HALtheWise/eclectronics-project2/README.md

# eclectronics-project2

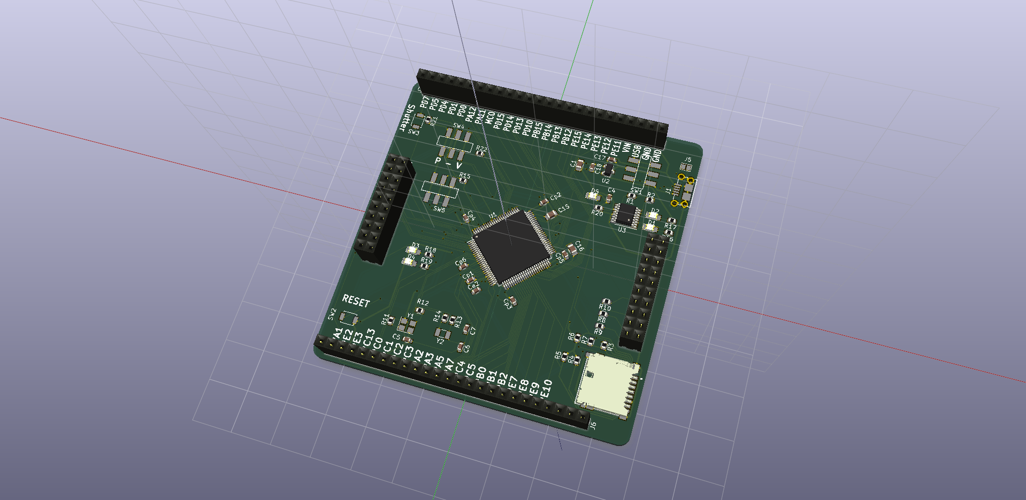
[picture p1: camboard/camboard.png]
camboard
