HALtheWise/eclectronics-project2/camboard/camboard.kicad_pcb

## KiCad design camboard/camboard.kicad_pcb (2017-10-13)

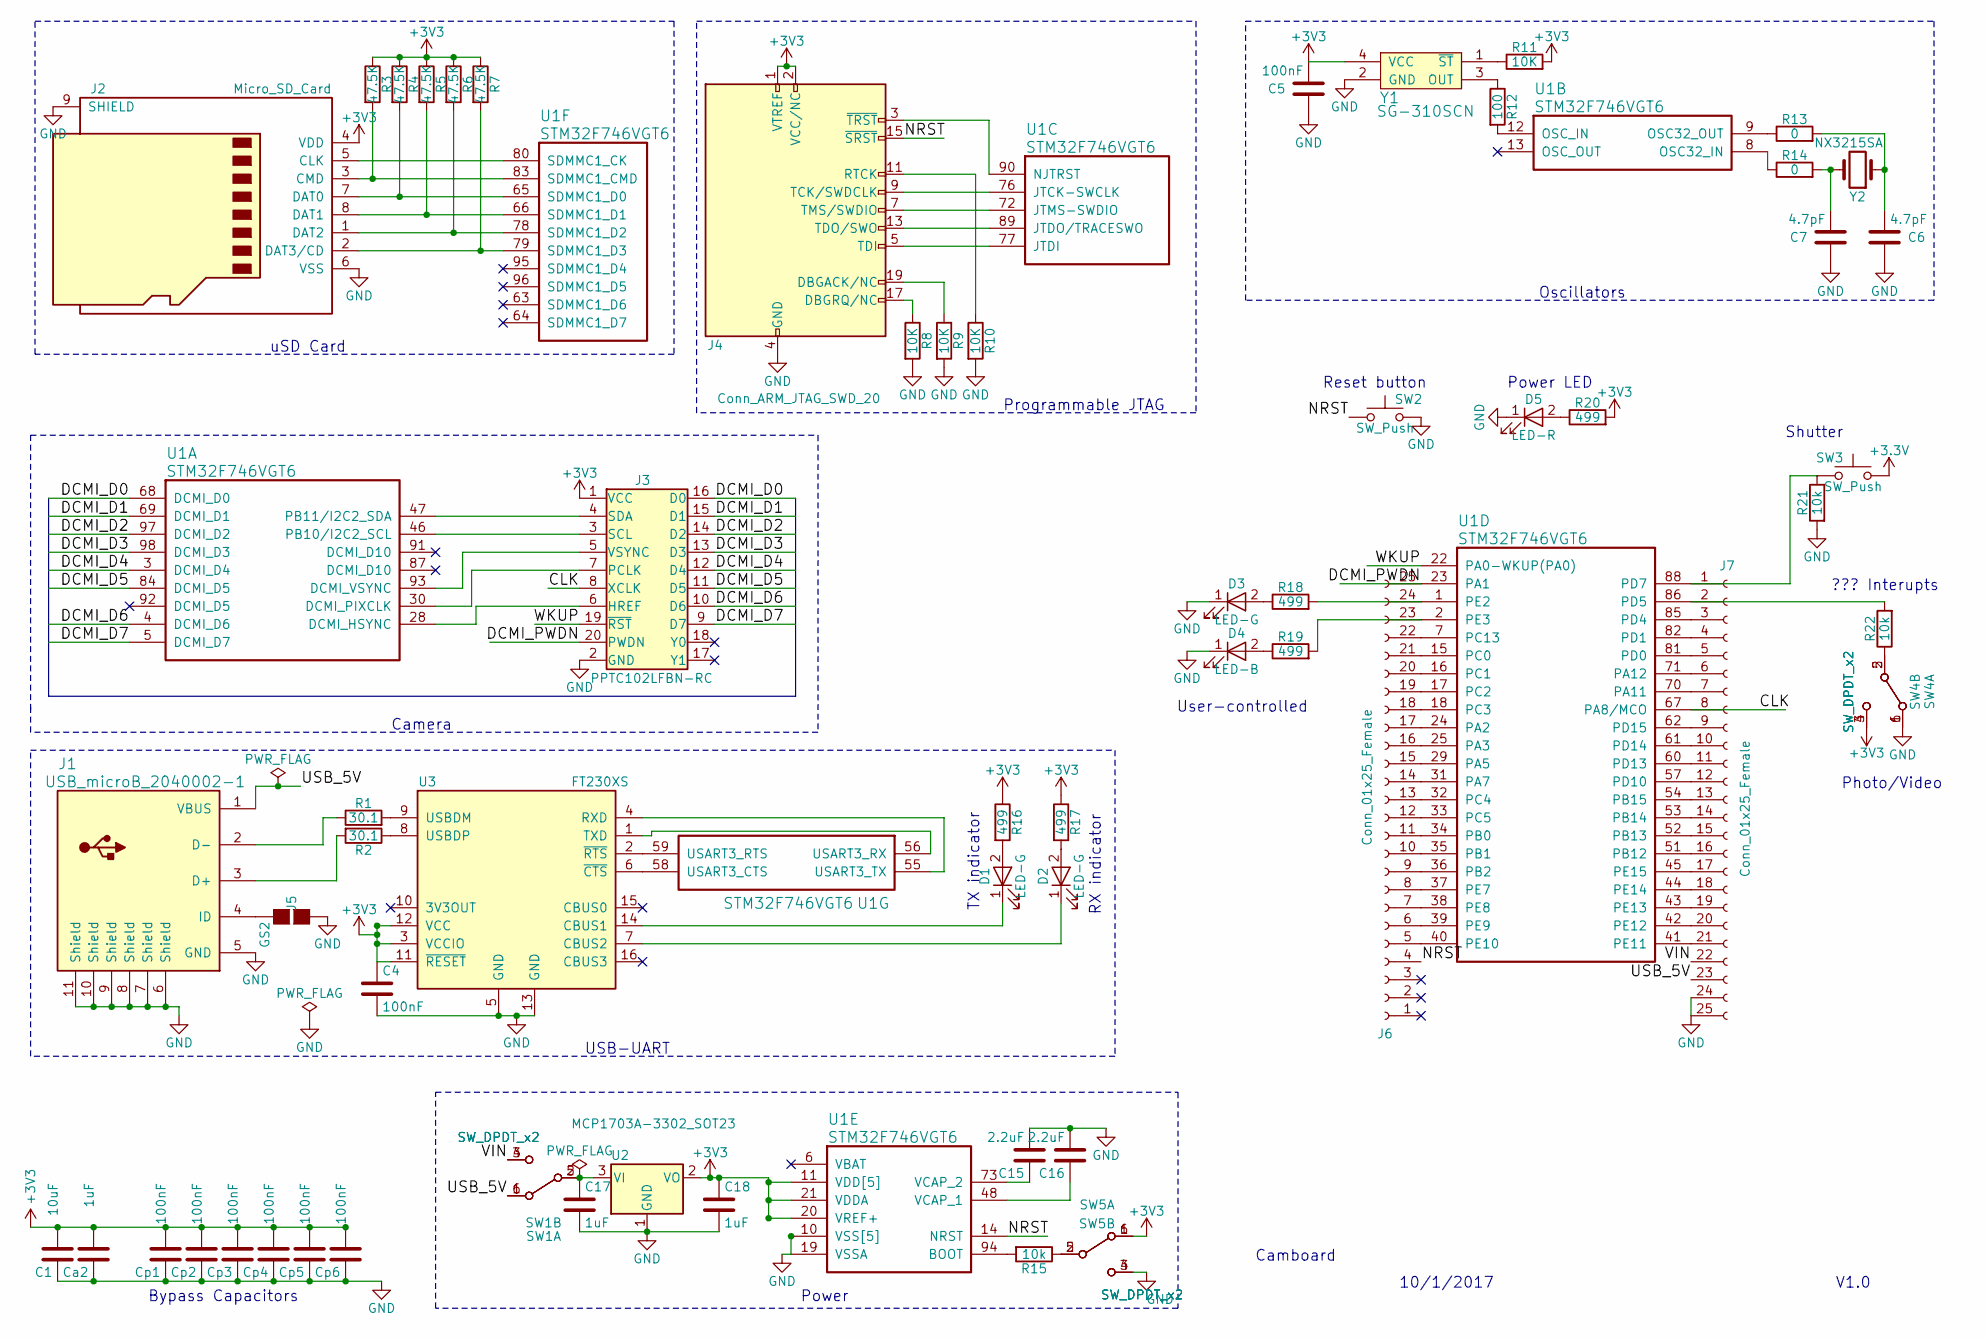
[picture p2: schematic camboard.sch]

Parts:
C1: 10uF; C_0805
C4, C5: 100nF; C_0603
C6, C7: 4.7pF; C_0603
C15, C16: 2.2uF; C_0805
C17, C18: 1uF; C_0603
Ca2: 1uF; C_0603
Cp1, Cp2, Cp3, Cp4, Cp5, Cp6: 100nF; C_0603
D1, D2, D3: LED-G; LED_0805
D4: LED-B; LED_0805
D5: LED-R; LED_0805
J1: USB_microB_2040002-1; USB_microB_2040002-1_alt
J2: Micro_SD_Card; 114-00841-68
J3: PPTC102LFBN-RC; Socket_Strip_Straight_2x10_Pitch2.54mm
J4: Conn_ARM_JTAG_SWD_20; Socket_Strip_Straight_2x10_Pitch2.54mm
J5: GS2
J6, J7: Conn_01x25_Female; Socket_Strip_Straight_1x25_Pitch2.54mm
R1, R2: 30.1; R_0603
R3, R4, R5, R6, R7: 47.5K; R_0603
R8, R9, R10, R11: 10K; R_0603
R12: 100; R_0603
R13, R14: 0; R_0603
R15, R21, R22: 10k; R_0603
R16, R17, R18, R19, R20: 499; R_0603
SW1, SW4, SW5: SW_DPDT_x2; JS202011SCQN
SW2, SW3: SW_Push; SW_SPST_B3U-1000P
U1: STM32F746VGT6; LQFP-100_14x14mm_Pitch0.5mm
U2: MCP1703A-3302_SOT23; SOT-23
U3: FT230XS; SSOP-16_3.9x4.9mm_Pitch0.635mm
Y1: SG-310SCN; Crystal_SMD_3225-4pin_3.2x2.5mm
Y2: NX3215SA; Crystal_SMD_3215-2pin_3.2x1.5mm

Connections:
/CLK: J3.8 (XCLK), J7.8, U1.67 (PA8/MCO)
/DCMI_D0: J3.16 (D0), U1.68 (DCMI_D0)
/DCMI_D1: J3.15 (D1), U1.69 (DCMI_D1)
/DCMI_D2: J3.14 (D2), U1.97 (DCMI_D2)
/DCMI_D3: J3.13 (D3), U1.98 (DCMI_D3)
/DCMI_D4: J3.12 (D4), U1.3 (DCMI_D4)
/DCMI_D5: J3.11 (D5), U1.84 (DCMI_D5)
/DCMI_D6: J3.10 (D6), U1.4 (DCMI_D6)
/DCMI_D7: J3.9 (D7), U1.5 (DCMI_D7)
/DCMI_PWDN: J3.20 (PWDN), J6.25, U1.23 (PA1)
/NRST: J4.15 (~SRST~), J6.4, SW2.1, U1.14 (NRST)
/USB_5V: J1.1 (VBUS), J7.23, SW1.1 (A), SW1.6 (A)
/VIN: J7.22, SW1.3 (C), SW1.4 (C)
/WKUP: J3.19 (~RST), U1.22 (PA0-WKUP(PA0))
GND: C1.1, C4.2, C5.1, C6.2, C7.1, C15.2, C16.2, C17.2, C18.2, Ca2.1, Cp1.1, Cp2.1, Cp3.1, Cp4.1, Cp5.1, Cp6.1, D3.1 (K), D4.1 (K), D5.1 (K), J1.5 (GND), J1.6 (Shield), J1.7 (Shield), J1.8 (Shield), J1.9 (Shield), J1.10 (Shield), J1.11 (Shield), J2.6 (VSS), J2.9 (SHIELD), J3.2 (GND), J4.4 (GND), J4.6 (GND), J4.8 (GND), J4.10 (GND), J4.12 (GND), J4.14 (GND), J4.16 (GND), J4.18 (GND), J4.20 (GND), J5.1 (G1), J7.24, J7.25, R8.2, R9.2, R10.2, R21.2, SW2.2, SW4.1 (A), SW4.6 (A), SW5.3 (C), SW5.4 (C), U1.10 (VSS[5]), U1.19 (VSSA), U1.26 (VSS[5]), U1.49 (VSS[5]), U1.74 (VSS[5]), U1.99 (VSS[5]), U2.1 (GND), U3.5 (GND), U3.13 (GND), Y1.2 (GND)
unnamed: C6.1, R13.2, Y2.1
unnamed: C7.2, R14.2, Y2.2
unnamed: C15.1, U1.73 (VCAP_2)
unnamed: C16.1, U1.48 (VCAP_1)
unnamed: C17.1, SW1.2 (B), SW1.5 (B), U2.3 (VI)
unnamed: D1.1 (K), U3.14 (CBUS1)
unnamed: D1.2 (A), R16.2
unnamed: D2.1 (K), U3.7 (CBUS2)
unnamed: D2.2 (A), R17.2
unnamed: D3.2 (A), R18.1
unnamed: D4.2 (A), R19.1
unnamed: D5.2 (A), R20.1
unnamed: J1.2 (D-), R1.1
unnamed: J1.3 (D+), R2.2
unnamed: J1.4 (ID), J5.2 (G2)
unnamed: J2.1 (DAT2), R6.2, U1.78 (SDMMC1_D2)
unnamed: J2.2 (DAT3/CD), R7.2, U1.79 (SDMMC1_D3)
unnamed: J2.3 (CMD), R3.2, U1.83 (SDMMC1_CMD)
unnamed: J2.5 (CLK), U1.80 (SDMMC1_CK)
unnamed: J2.7 (DAT0), R4.2, U1.65 (SDMMC1_D0)
unnamed: J2.8 (DAT1), R5.2, U1.66 (SDMMC1_D1)
unnamed: J3.3 (SCL), U1.46 (PB10/I2C2_SCL)
unnamed: J3.4 (SDA), U1.47 (PB11/I2C2_SDA)
unnamed: J3.5 (VSYNC), U1.93 (DCMI_VSYNC)
unnamed: J3.6 (HREF), U1.28 (DCMI_HSYNC)
unnamed: J3.7 (PCLK), U1.30 (DCMI_PIXCLK)
unnamed: J4.3 (~TRST~), U1.90 (NJTRST)
unnamed: J4.5 (TDI), U1.77 (JTDI)
unnamed: J4.7 (TMS/SWDIO), U1.72 (JTMS-SWDIO)
unnamed: J4.9 (TCK/SWDCLK), U1.76 (JTCK-SWCLK)
unnamed: J4.11 (RTCK), R10.1
unnamed: J4.13 (TDO/SWO), U1.89 (JTDO/TRACESWO)
unnamed: J4.17 (DBGRQ/NC), R8.1
unnamed: J4.19 (DBGACK/NC), R9.1
unnamed: J6.5, U1.40 (PE10)
unnamed: J6.6, U1.39 (PE9)
unnamed: J6.7, U1.38 (PE8)
unnamed: J6.8, U1.37 (PE7)
unnamed: J6.9, U1.36 (PB2)
unnamed: J6.10, U1.35 (PB1)
unnamed: J6.11, U1.34 (PB0)
unnamed: J6.12, U1.33 (PC5)
unnamed: J6.13, U1.32 (PC4)
unnamed: J6.14, U1.31 (PA7)
unnamed: J6.15, U1.29 (PA5)
unnamed: J6.16, U1.25 (PA3)
unnamed: J6.17, U1.24 (PA2)
unnamed: J6.18, U1.18 (PC3)
unnamed: J6.19, U1.17 (PC2)
unnamed: J6.20, U1.16 (PC1)
unnamed: J6.21, U1.15 (PC0)
unnamed: J6.22, U1.7 (PC13)
unnamed: J6.23, R19.2, U1.2 (PE3)
unnamed: J6.24, R18.2, U1.1 (PE2)
unnamed: J7.1, R21.1, SW3.2, U1.88 (PD7)
unnamed: J7.2, R22.2, U1.86 (PD5)
unnamed: J7.3, U1.85 (PD4)
unnamed: J7.4, U1.82 (PD1)
unnamed: J7.5, U1.81 (PD0)
unnamed: J7.6, U1.71 (PA12)
unnamed: J7.7, U1.70 (PA11)
unnamed: J7.9, U1.62 (PD15)
unnamed: J7.10, U1.61 (PD14)
unnamed: J7.11, U1.60 (PD13)
unnamed: J7.12, U1.57 (PD10)
unnamed: J7.13, U1.54 (PB15)
unnamed: J7.14, U1.53 (PB14)
unnamed: J7.15, U1.52 (PB13)
unnamed: J7.16, U1.51 (PB12)
unnamed: J7.17, U1.45 (PE15)
unnamed: J7.18, U1.44 (PE14)
unnamed: J7.19, U1.43 (PE13)
unnamed: J7.20, U1.42 (PE12)
unnamed: J7.21, U1.41 (PE11)
unnamed: R1.2, U3.9 (USBDM)
unnamed: R2.1, U3.8 (USBDP)
unnamed: R11.1, Y1.1 (~ST)
unnamed: R12.1, Y1.3 (OUT)
unnamed: R12.2, U1.12 (OSC_IN)
unnamed: R13.1, U1.9 (OSC32_OUT)
unnamed: R14.1, U1.8 (OSC32_IN)
unnamed: R15.1, SW5.2 (B), SW5.5 (B)
unnamed: R15.2, U1.94 (BOOT)
unnamed: R22.1, SW4.2 (B), SW4.5 (B)
unnamed: U1.55 (USART3_TX), U3.4 (RXD)
unnamed: U1.56 (USART3_RX), U3.1 (TXD)
unnamed: U1.58 (USART3_CTS), U3.6 (~CTS)
unnamed: U1.59 (USART3_RTS), U3.2 (~RTS)

Notes on the sheet:
Oscillators
USB-UART
uSD Card
Camera
Programmable JTAG
Power
RX indicator
TX indicator
Photo/Video
Shutter
Power LED
Reset button
User-controlled
Bypass Capacitors
Camboard
10/1/2017
V1.0
??? Interupts

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
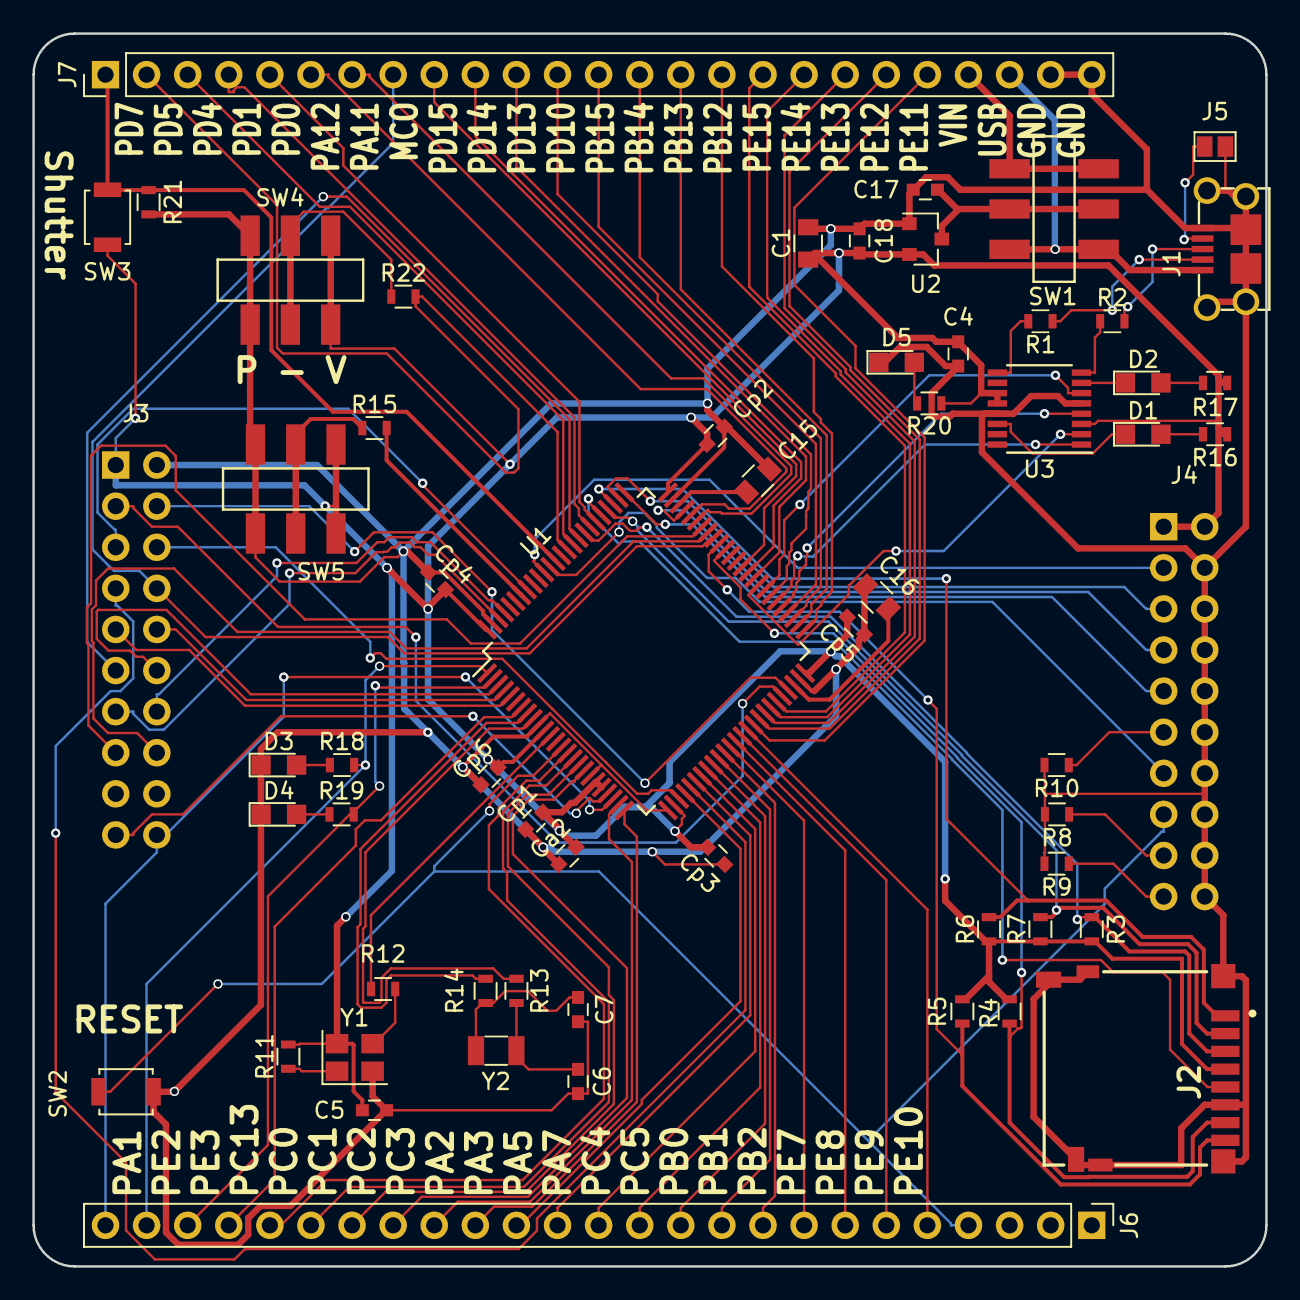
[picture p3: board camboard.kicad_pcb from above]

Board: 2 copper layers, 76.2 x 76.2 mm, 60 parts (0 on the bottom side), 104 nets.
