HALtheWise/eclectronics-project2/code/barecube/BareCubeMX/Src/main.c

/**
  ******************************************************************************
  * File Name          : main.c
  * Description        : Main program body
  ******************************************************************************
  ** This notice applies to any and all portions of this file
  * that are not between comment pairs USER CODE BEGIN and
  * USER CODE END. Other portions of this file, whether 
  * inserted by the user or by software development tools
  * are owned by their respective copyright owners.
  *
  * COPYRIGHT(c) 2017 STMicroelectronics
  *
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
  ******************************************************************************
  */

/* Includes ------------------------------------------------------------------*/
#include "main.h"
#include "stm32f7xx_hal.h"


DCMI_HandleTypeDef hdcmi;

I2C_HandleTypeDef hi2c2;

UART_HandleTypeDef huart3;

/* USER CODE BEGIN PV */

/* USER CODE END PV */

void SystemClock_Config(void);
static void MX_GPIO_Init(void);
static void MX_USART3_UART_Init(void);
static void MX_DCMI_Init(void);
static void MX_I2C2_Init(void);

/* USER CODE BEGIN PFP */

/* USER CODE END PFP */

/* USER CODE BEGIN 0 */
#define OV7720_REG_NUM 			4
#define OV7720_WRITE_ADDR 	    0x42
#define OV7720_READ_ADDR 		0x43

#define OV2640_I2C_ADDR         0x30

#define IMG_ROWS    320
#define IMG_COLUMNS 240
/* USER CODE END 0 */

int main(void)
{

  /* MCU Configuration----------------------------------------------------------*/

  /* Reset of all peripherals, Initializes the Flash interface and the Systick. */
  HAL_Init();

  /* Configure the system clock */
  SystemClock_Config();

  /* Initialize all configured peripherals */
  MX_GPIO_Init();
  MX_USART3_UART_Init();
  MX_DCMI_Init();
  MX_I2C2_Init();

  /* USER CODE BEGIN 2 */

  HAL_GPIO_WritePin(CAM_RESET_GPIO_Port, CAM_RESET_Pin, 1);
  /* USER CODE END 2 */

  /* Infinite loop */
  /* USER CODE BEGIN WHILE */
  while (1)
  {

	  // GPIO
	  HAL_GPIO_TogglePin(LEDR_GPIO_Port, LEDR_Pin);
	  HAL_Delay(500);

	  HAL_GPIO_WritePin(LEDG_GPIO_Port, LEDG_Pin,
			  HAL_GPIO_ReadPin(PVSWITCH_GPIO_Port,PVSWITCH_Pin));

	  uint8_t i2cbuffer[10] = {42};

	  int error = HAL_I2C_Mem_Read(&hi2c2, OV2640_I2C_ADDR, 0x00, I2C_MEMADD_SIZE_8BIT, &i2cbuffer,1 ,1000);

	  uint8_t str[100]={};
	  sprintf(str, "Data from i2c: %x (error %x)\n", i2cbuffer[0], error);
	  HAL_UART_Transmit(&huart3, str, strlen(str), 0xFFFF);

	  for (int i = 0; i < 256; i++){
		  uint8_t str[100]={};
		  if(0==HAL_I2C_IsDeviceReady(&hi2c2, i, 2, 100)){
			  sprintf(str, "Response from device %x \n", i);
			  HAL_UART_Transmit(&huart3, str, strlen(str), 0xFFFF);
		  }

	  }
  /* USER CODE END WHILE */

  /* USER CODE BEGIN 3 */

  }
  /* USER CODE END 3 */

}

/** System Clock Configuration
*/
void SystemClock_Config(void)
{

  RCC_OscInitTypeDef RCC_OscInitStruct;
  RCC_ClkInitTypeDef RCC_ClkInitStruct;
  RCC_PeriphCLKInitTypeDef PeriphClkInitStruct;

    /**Configure the main internal regulator output voltage 
    */
  __HAL_RCC_PWR_CLK_ENABLE();

  __HAL_PWR_VOLTAGESCALING_CONFIG(PWR_REGULATOR_VOLTAGE_SCALE3);

    /**Initializes the CPU, AHB and APB busses clocks 
    */
  RCC_OscInitStruct.OscillatorType = RCC_OSCILLATORTYPE_HSI;
  RCC_OscInitStruct.HSIState = RCC_HSI_ON;
  RCC_OscInitStruct.HSICalibrationValue = 16;
  RCC_OscInitStruct.PLL.PLLState = RCC_PLL_NONE;
  if (HAL_RCC_OscConfig(&RCC_OscInitStruct) != HAL_OK)
  {
    _Error_Handler(__FILE__, __LINE__);
  }

    /**Initializes the CPU, AHB and APB busses clocks 
    */
  RCC_ClkInitStruct.ClockType = RCC_CLOCKTYPE_HCLK|RCC_CLOCKTYPE_SYSCLK
                              |RCC_CLOCKTYPE_PCLK1|RCC_CLOCKTYPE_PCLK2;
  RCC_ClkInitStruct.SYSCLKSource = RCC_SYSCLKSOURCE_HSI;
  RCC_ClkInitStruct.AHBCLKDivider = RCC_SYSCLK_DIV1;
  RCC_ClkInitStruct.APB1CLKDivider = RCC_HCLK_DIV1;
  RCC_ClkInitStruct.APB2CLKDivider = RCC_HCLK_DIV1;

  if (HAL_RCC_ClockConfig(&RCC_ClkInitStruct, FLASH_LATENCY_0) != HAL_OK)
  {
    _Error_Handler(__FILE__, __LINE__);
  }

  PeriphClkInitStruct.PeriphClockSelection = RCC_PERIPHCLK_USART3|RCC_PERIPHCLK_I2C2;
  PeriphClkInitStruct.Usart3ClockSelection = RCC_USART3CLKSOURCE_PCLK1;
  PeriphClkInitStruct.I2c2ClockSelection = RCC_I2C2CLKSOURCE_PCLK1;
  if (HAL_RCCEx_PeriphCLKConfig(&PeriphClkInitStruct) != HAL_OK)
  {
    _Error_Handler(__FILE__, __LINE__);
  }

    /**Configure the Systick interrupt time 
    */
  HAL_SYSTICK_Config(HAL_RCC_GetHCLKFreq()/1000);

    /**Configure the Systick 
    */
  HAL_SYSTICK_CLKSourceConfig(SYSTICK_CLKSOURCE_HCLK);

  /* SysTick_IRQn interrupt configuration */
  HAL_NVIC_SetPriority(SysTick_IRQn, 0, 0);
}

/* DCMI init function */
static void MX_DCMI_Init(void)
{

  hdcmi.Instance = DCMI;
  hdcmi.Init.SynchroMode = DCMI_SYNCHRO_HARDWARE;
  hdcmi.Init.PCKPolarity = DCMI_PCKPOLARITY_FALLING;
  hdcmi.Init.VSPolarity = DCMI_VSPOLARITY_LOW;
  hdcmi.Init.HSPolarity = DCMI_HSPOLARITY_LOW;
  hdcmi.Init.CaptureRate = DCMI_CR_ALL_FRAME;
  hdcmi.Init.ExtendedDataMode = DCMI_EXTEND_DATA_8B;
  hdcmi.Init.JPEGMode = DCMI_JPEG_DISABLE;
  hdcmi.Init.ByteSelectMode = DCMI_BSM_ALL;
  hdcmi.Init.ByteSelectStart = DCMI_OEBS_ODD;
  hdcmi.Init.LineSelectMode = DCMI_LSM_ALL;
  hdcmi.Init.LineSelectStart = DCMI_OELS_ODD;
  if (HAL_DCMI_Init(&hdcmi) != HAL_OK)
  {
    _Error_Handler(__FILE__, __LINE__);
  }

}

/* I2C2 init function */
static void MX_I2C2_Init(void)
{

  hi2c2.Instance = I2C2;
  hi2c2.Init.Timing = 0x00303D5B;
  hi2c2.Init.OwnAddress1 = 0;
  hi2c2.Init.AddressingMode = I2C_ADDRESSINGMODE_7BIT;
  hi2c2.Init.DualAddressMode = I2C_DUALADDRESS_DISABLE;
  hi2c2.Init.OwnAddress2 = 0;
  hi2c2.Init.OwnAddress2Masks = I2C_OA2_NOMASK;
  hi2c2.Init.GeneralCallMode = I2C_GENERALCALL_DISABLE;
  hi2c2.Init.NoStretchMode = I2C_NOSTRETCH_DISABLE;
  if (HAL_I2C_Init(&hi2c2) != HAL_OK)
  {
    _Error_Handler(__FILE__, __LINE__);
  }

    /**Configure Analogue filter 
    */
  if (HAL_I2CEx_ConfigAnalogFilter(&hi2c2, I2C_ANALOGFILTER_ENABLE) != HAL_OK)
  {
    _Error_Handler(__FILE__, __LINE__);
  }

    /**Configure Digital filter 
    */
  if (HAL_I2CEx_ConfigDigitalFilter(&hi2c2, 0) != HAL_OK)
  {
    _Error_Handler(__FILE__, __LINE__);
  }

}

/* USART3 init function */
static void MX_USART3_UART_Init(void)
{

  huart3.Instance = USART3;
  huart3.Init.BaudRate = 115200;
  huart3.Init.WordLength = UART_WORDLENGTH_8B;
  huart3.Init.StopBits = UART_STOPBITS_1;
  huart3.Init.Parity = UART_PARITY_NONE;
  huart3.Init.Mode = UART_MODE_TX_RX;
  huart3.Init.HwFlowCtl = UART_HWCONTROL_NONE;
  huart3.Init.OverSampling = UART_OVERSAMPLING_16;
  huart3.Init.OneBitSampling = UART_ONE_BIT_SAMPLE_DISABLE;
  huart3.AdvancedInit.AdvFeatureInit = UART_ADVFEATURE_NO_INIT;
  if (HAL_UART_Init(&huart3) != HAL_OK)
  {
    _Error_Handler(__FILE__, __LINE__);
  }

}

/** Configure pins as 
        * Analog 
        * Input 
        * Output
        * EVENT_OUT
        * EXTI
*/
static void MX_GPIO_Init(void)
{

  GPIO_InitTypeDef GPIO_InitStruct;

  /* GPIO Ports Clock Enable */
  __HAL_RCC_GPIOE_CLK_ENABLE();
  __HAL_RCC_GPIOA_CLK_ENABLE();
  __HAL_RCC_GPIOB_CLK_ENABLE();
  __HAL_RCC_GPIOD_CLK_ENABLE();

  /*Configure GPIO pin Output Level */
  HAL_GPIO_WritePin(LEDG_GPIO_Port, LEDG_Pin, GPIO_PIN_RESET);

  /*Configure GPIO pin Output Level */
  HAL_GPIO_WritePin(LEDR_GPIO_Port, LEDR_Pin, GPIO_PIN_SET);

  /*Configure GPIO pin Output Level */
  HAL_GPIO_WritePin(CAM_RESET_GPIO_Port, CAM_RESET_Pin, GPIO_PIN_SET);

  /*Configure GPIO pins : LEDG_Pin LEDR_Pin */
  GPIO_InitStruct.Pin = LEDG_Pin|LEDR_Pin;
  GPIO_InitStruct.Mode = GPIO_MODE_OUTPUT_PP;
  GPIO_InitStruct.Pull = GPIO_NOPULL;
  GPIO_InitStruct.Speed = GPIO_SPEED_FREQ_LOW;
  HAL_GPIO_Init(GPIOE, &GPIO_InitStruct);

  /*Configure GPIO pin : CAM_RESET_Pin */
  GPIO_InitStruct.Pin = CAM_RESET_Pin;
  GPIO_InitStruct.Mode = GPIO_MODE_OUTPUT_PP;
  GPIO_InitStruct.Pull = GPIO_PULLUP;
  GPIO_InitStruct.Speed = GPIO_SPEED_FREQ_LOW;
  HAL_GPIO_Init(CAM_RESET_GPIO_Port, &GPIO_InitStruct);

  /*Configure GPIO pins : PVSWITCH_Pin SHUTTER_Pin */
  GPIO_InitStruct.Pin = PVSWITCH_Pin|SHUTTER_Pin;
  GPIO_InitStruct.Mode = GPIO_MODE_INPUT;
  GPIO_InitStruct.Pull = GPIO_NOPULL;
  HAL_GPIO_Init(GPIOD, &GPIO_InitStruct);

}

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
