HALtheWise/eclectronics-project2/code/barecube/BareCubeMX/BareCubeMX.ioc

Mcu.UserName=STM32F746VGTx
PA0/WKUP.GPIO_Label=CAM_RESET
PA0/WKUP.Signal=GPIO_Output
PA10.Signal=DCMI_D1
PA4.Signal=DCMI_HSYNC
PA6.Signal=DCMI_PIXCLK
PA9.Signal=DCMI_D0
PB10.Signal=I2C2_SCL
PB11.Signal=I2C2_SDA
PB7.Signal=DCMI_VSYNC
PD3.Signal=DCMI_D5
PD5.GPIO_Label=PVSWITCH
PD5.Signal=GPIO_Input
PD7.GPIO_Label=SHUTTER
PD7.Signal=GPIO_Input
PD8.Signal=USART3_TX
PD9.Signal=USART3_RX
PE0.Signal=DCMI_D2
PE1.Signal=DCMI_D3
PE2.GPIO_Label=LEDG
PE2.Signal=GPIO_Output
PE3.GPIO_Label=LEDR
PE3.Signal=GPIO_Output
PE4.Signal=DCMI_D4
PE5.Signal=DCMI_D6
PE6.Signal=DCMI_D7
