HALtheWise/eclectronics-project2/(commit log)

2017-09-23 Added gitignore for kicad
2017-09-25 Created kicad project
    [camboard.kicad_pcb, camboard.sch]
2017-09-25 Assigned pin numbers for DCMI camer interface
2017-09-26 Final changes after class for STM32 part
2017-09-27 Added v2 of stm32 chip, made using kipart
2017-09-27 Added processor to schematic
    [camboard.sch]
2017-09-27 Added camera connector library
2017-09-27 Added footprint for processor
2017-09-27 Added JTAG port schematic
    [_saved_camboard (copy).sch, camboard (copy).sch]
2017-09-27 Moved components into proper directory
    [_saved_camboard (copy).sch, camboard (copy).sch]
2017-09-27 added oscillators
    [camboard.sch]
2017-09-27 Added more components and fixed SD card pinout
    [_saved_camboard (copy).sch]
2017-09-27 fixed wrong library reference and added power select
    [camboard.sch]
2017-09-27 Added button
2017-09-27 more connections
    [camboard.sch]
2017-09-27 added microSD connections, camera very ambiguous
    [camboard.sch]
2017-09-28 added JTAG Connection
    [camboard.sch]
2017-09-28 added usb-uart
    [camboard.sch]
2017-09-28 some peripherals are done
    [camboard.sch]
2017-09-28 added some labels
    [camboard.sch]
2017-09-28 Added i2c pins to camera block
    [_saved_camboard (copy).sch, camboard (copy).sch]
2017-09-28 Fixed camera connections
    [camboard.sch]
2017-09-28 Added bypass caps
    [camboard.sch]
2017-09-28 Fixed some issues
    [camboard.sch]
2017-09-29 added USB micro
    [camboard.sch]
2017-09-29 modified resistor values, etc.
    [camboard.sch]
2017-09-29 Added headers
    [camboard.sch]
2017-09-29 Added longer headers
    [camboard.sch]
2017-09-29 Added user-controlled buttons and LED's
    [camboard.sch]
2017-10-01 modifying layout to maximize spacing between logical units, some footprint association. set LED resistance to 100 ohms for now.
    [camboard.sch]
2017-10-01 Adjusted resistor values and stuff
    [camboard.sch]
2017-10-05 Added boxes
    [camboard.sch]
2017-10-05 Schematic review
    [camboard.sch]
2017-10-06 updated connectorsx25 and associated most footprints
    [camboard.sch]
2017-10-06 added DPDT Switch Footprints
    [camboard.sch]
2017-10-06 fixed switch annotation
    [camboard.kicad_pcb, camboard.sch]
2017-10-06 Fixed some notes from design review
    [camboard.sch]
2017-10-06 Fixed oscillator symbol
    [camboard.sch]
2017-10-06 Finished schematic
    [camboard.sch]
2017-10-07 Fixed some footprints
    [camboard.sch]
2017-10-07 updated switch schematic
2017-10-07 properly updated switch
    [camboard.sch]
2017-10-07 Placed components (for now)
    [camboard.kicad_pcb]
2017-10-07 remove cp7
    [camboard.sch]
2017-10-07 Finished(ish) placing components
    [camboard.kicad_pcb, camboard.sch]
2017-10-07 fixed jtag
    [camboard.kicad_pcb, camboard.sch]
2017-10-07 Manual pre-routing of power
    [camboard.kicad_pcb, camboard.sch]
2017-10-07 The ladybug is happy
    [camboard.kicad_pcb]
2017-10-11 Moved SD card and processor
    [camboard.kicad_pcb]
2017-10-11 Kept moving parts
    [camboard.kicad_pcb, camboard.sch]
2017-10-11 More power traces and cam clock
    [camboard.kicad_pcb]
2017-10-11 Moved some more components
    [camboard.kicad_pcb]
2017-10-11 Final autorouting
    [camboard.kicad_pcb]
2017-10-12 updated pcb
    [camboard.kicad_pcb]
2017-10-12 Fixed some silly traces
    [camboard.kicad_pcb]
2017-10-12 More changes
    [camboard.kicad_pcb]
2017-11-29 Started working on code
    [3v3reg.sch, 3v3regv2.sch, camboard.sch, usb_uart.sch]
2017-11-30 Finished work 11/29
    [camboard-v2 Run.cfg]
2017-12-15 Added I2C support
2017-12-15 Began working with I2C
2017-12-15 Added reset pin for camera
