HALtheWise/eclectronics-project2/(notices)

Notices in the files:
code/barecube/BareCubeMX/Src/main.c:
(C) COPYRIGHT STMicroelectronics *****END OF FILE
